jsr606/klangfarve/documentation/photos/indoor electronics.png

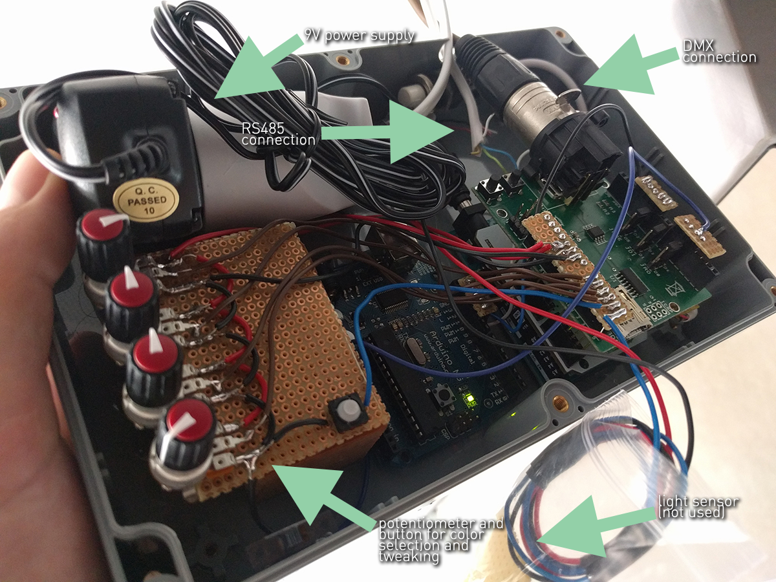
documentation/photos/indoor electronics.png
