jsr606/klangfarve/documentation/photos/outdoor electronics.png

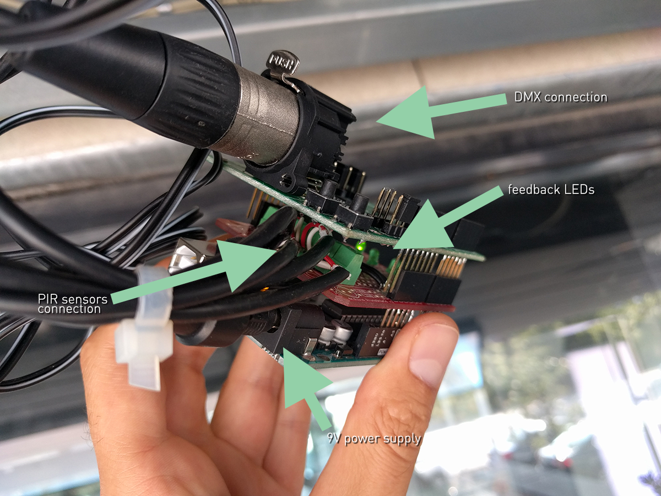
documentation/photos/outdoor electronics.png
