jsr606/klangfarve/README.md

# KLANG FARVE

kildekode, kablingsdiagrammer, dokumentation og manualer til KLANG FARVE projektet af viera collaro og jacob kierkegaard, musikkens hus 2016

dette er tænkt som dokumentation af installationen, samt som en hjælp ift. vedligeholdelse / servicering af samme.

denne dokumentation dækker kun lyssiden af installation og programmeringen af samme, ikke lydsiden.

dokumentationen er udviklet af jacob remin i september 2016, projektet er udviklet og installeret i samarbejde med viera collaro og neon sign i 2016.
