jsr606/klangfarve/documentation/README.md

#HARDWARE

## microcontrollers:

arduino UNO: https://www.arduino.cc/en/Main/ArduinoBoardUno

DMX shield: futura group DMX shield: https://store.open-electronics.org/DMX_shield

R485 shield: linksprite R485 shield: http://linksprite.com/wiki/index.php5?title=RS485_Shield_V2.1_for_Arduino

## sensors:

outdoor:

PIR motion sensors: futura group PIR motion sensor: https://store.open-electronics.org/PIRMOD

indoor:

distance sensor: leddar one fra leddar tech: http://leddartech.com/modules/leddarone/

## LED controller

DMX -> RGBW controller by solid apollo: http://www.solidapollo.com/ichroma-dmx-rgbw-led-controller.html

#SOFTWARE

all code written in arduino: https://www.arduino.cc/

Arduino library for leddar one: http://playground.arduino.cc/Code/Leddar

DMX simple library: https://code.google.com/archive/p/tinkerit/wikis/DmxSimple.wiki
