jsr606/klangfarve/documentation/schematics/shield connection.pdf

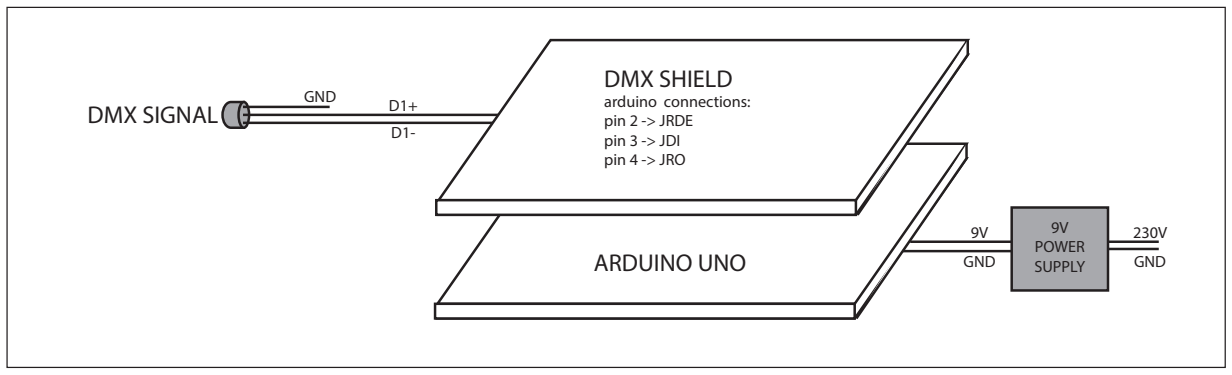
[picture p6: figure]
DMX SIGNAL; D1+ GND; ARDUINO UNO; 9V GND; 230V GND; 9V POWER SUPPLY; DMX SHIELD arduino connections: pin 2 -> JRDE pin 3 -> JDI pin 4 -> JRO

# UDENDØRS INSTALLATION

# KLANG FARVE

# elektronikdiagram arduino til shield forbindelser

# af jacob remin 26/11-2016

# INDENDØRS INSTALLATION, FORSIMPLET VERSION

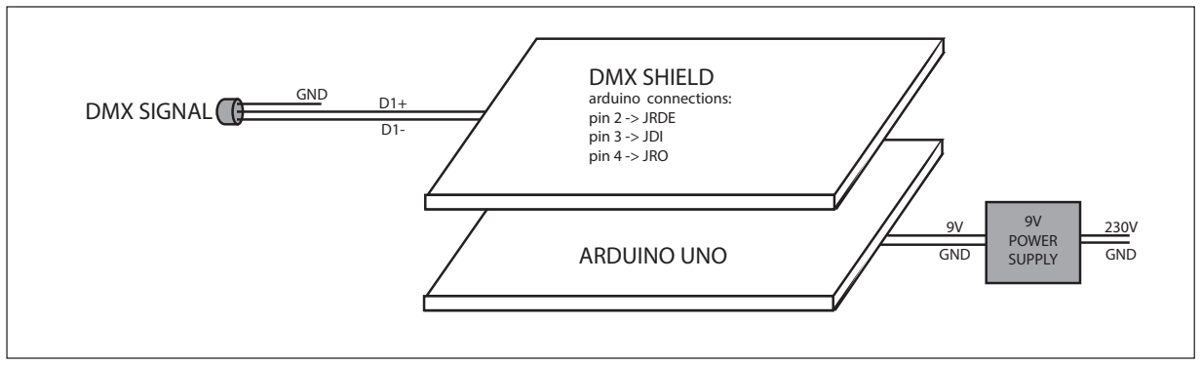
[picture p7: figure]
DMX SIGNAL; D1+ GND; ARDUINO UNO; 9V GND; 230V GND; 9V POWER SUPPLY; DMX SHIELD arduino connections: pin 2 -> JRDE pin 3 -> JDI pin 4 -> JRO
