jsr606/klangfarve/documentation/kablingsdiagram viera.pdf

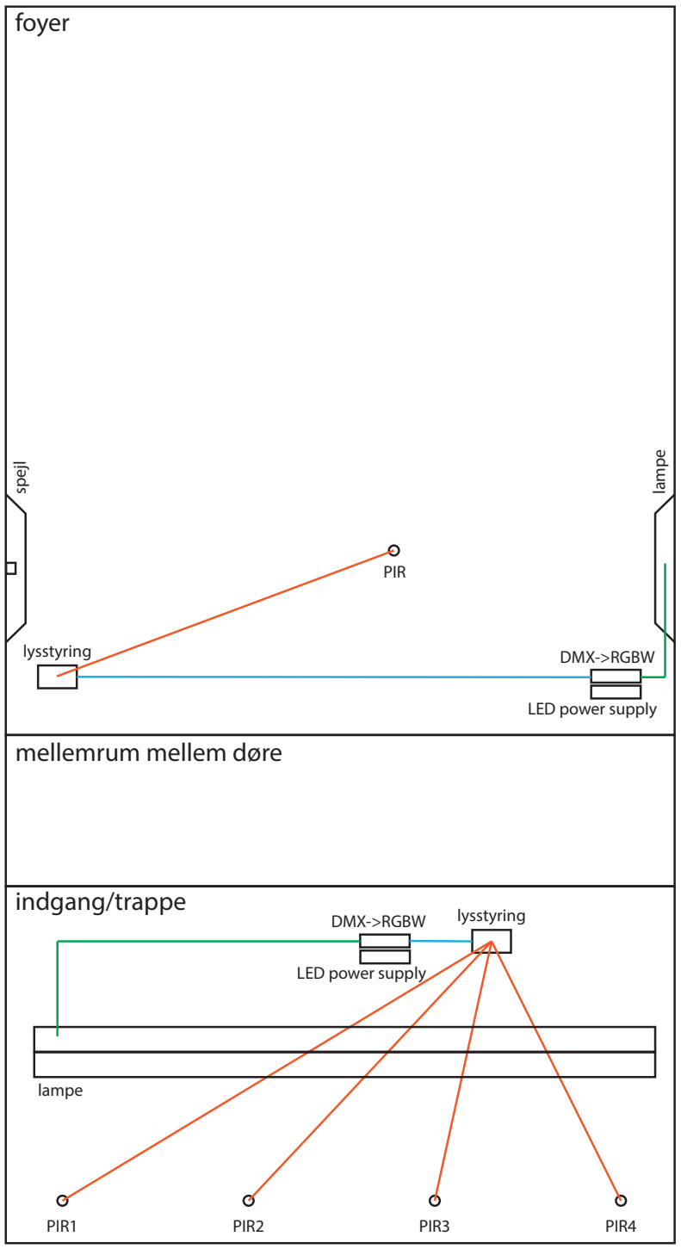
[picture p8: figure]
foyer; indgang/trappe; PIR1; PIR2; PIR3; PIR4; mellemrum mellem døre; lysstyring; DMX->RGBW; LED power supply; spejl; lampe; PIR

4-polet ledning
DMX signal
RGBW LED spænding

kablingsdiagram
KLANG FARVE
lys kabling
af jacob remin 26/11-2016
