jsr606/klangfarve/documentation/photos/LED drivers.png

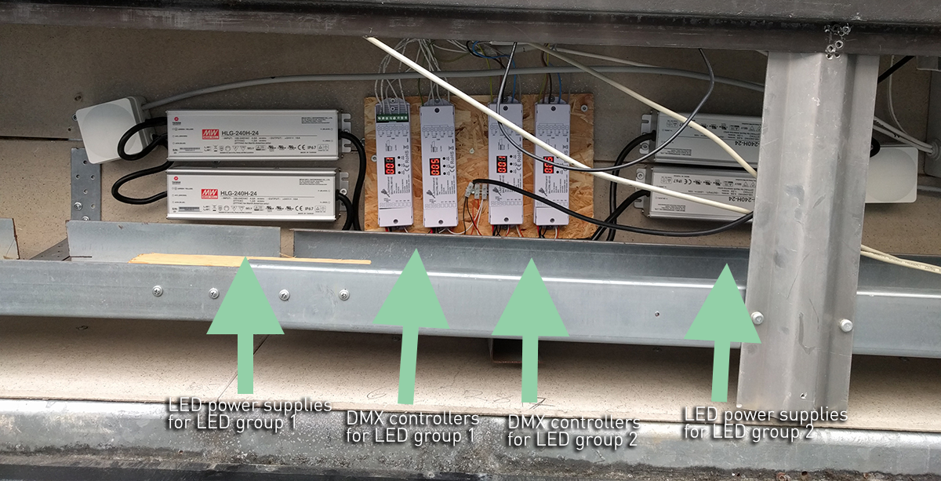
documentation/photos/LED drivers.png
