jsr606/klangfarve/documentation/photos/PIR-sensor-pinout-and-settings.png

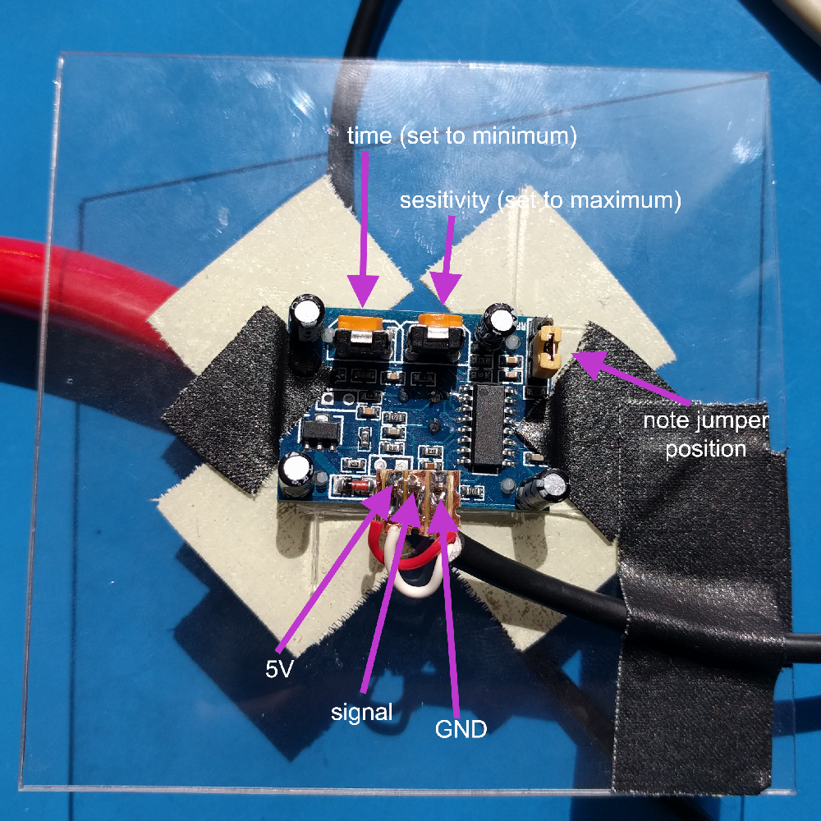
documentation/photos/PIR-sensor-pinout-and-settings.png
