jsr606/klangfarve/documentation/photos/sensorplacering.jpg

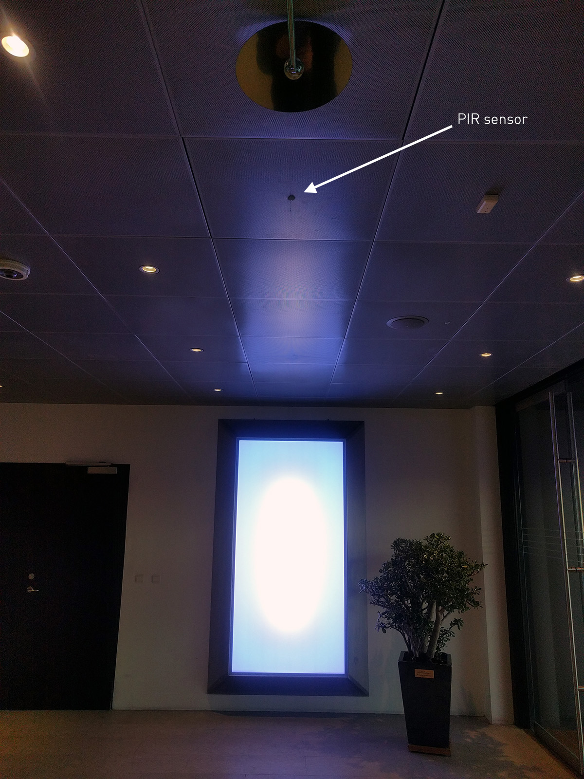
documentation/photos/sensorplacering.jpg
