jsr606/klangfarve/documentation/schematics/indoor schematic.jpg

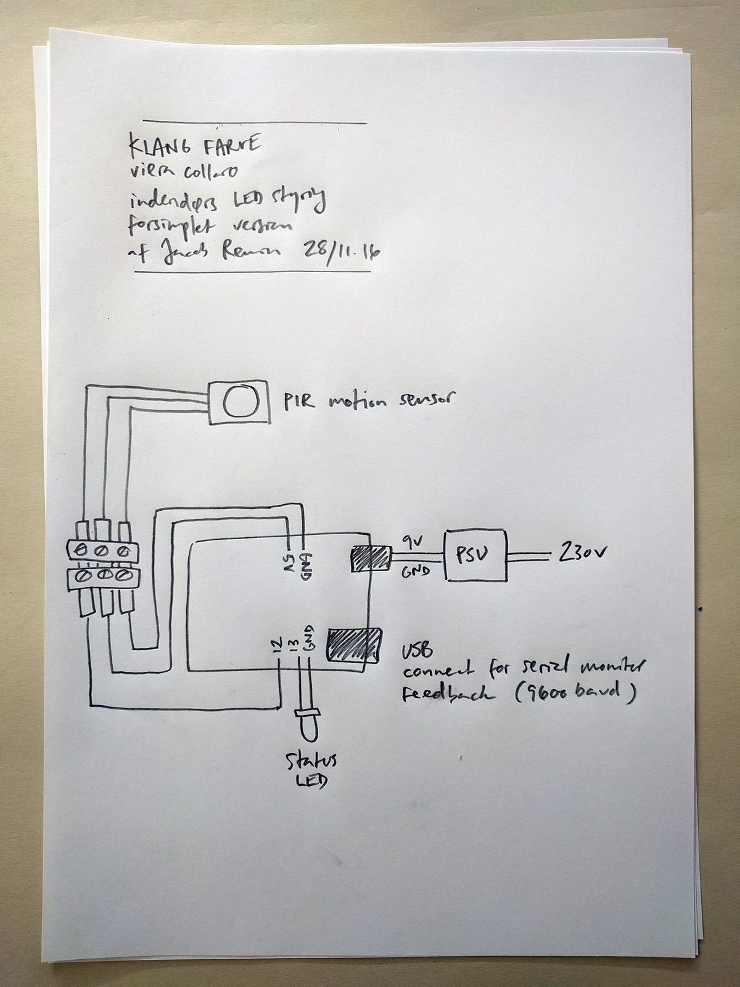
documentation/schematics/indoor schematic.jpg
