jsr606/klangfarve/documentation/schematics/shield connection.png

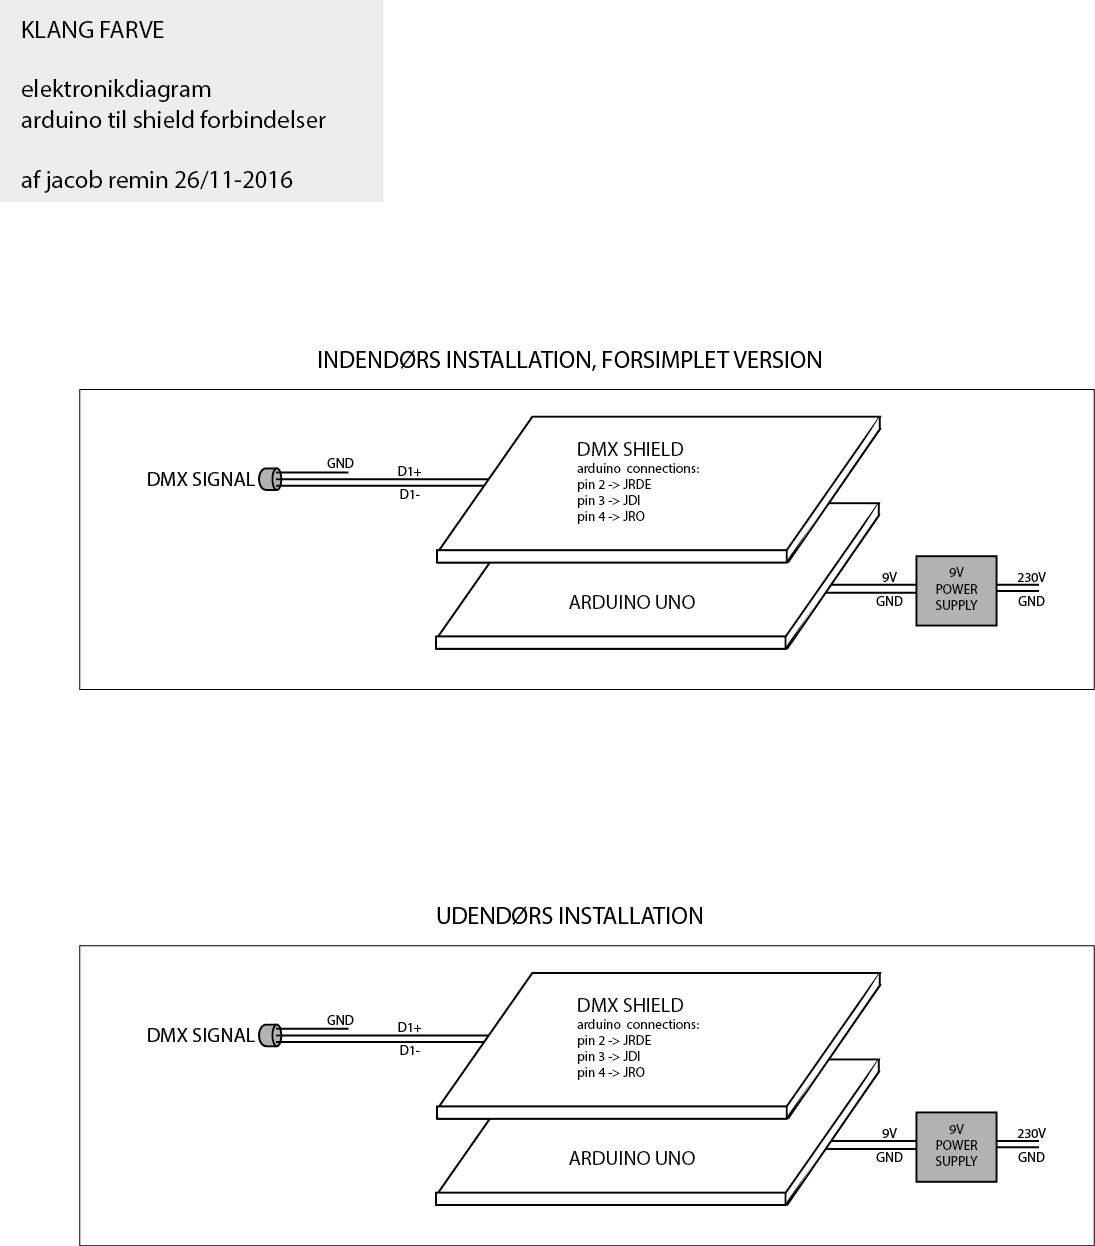
documentation/schematics/shield connection.png
