jsr606/klangfarve/(commit log)

2016-09-11 added schematics
2016-09-11 leddar one user guide added
2016-09-11 added arduino libraries
2016-11-28 ny elektronik: PIR sensor frem for leddarOne
2016-11-28 new arduino code for indoor PIR
2016-11-29 sensor placering indendørs installation
